antevens/fan-shroud/print/coupons/coupon_pocket.3mf

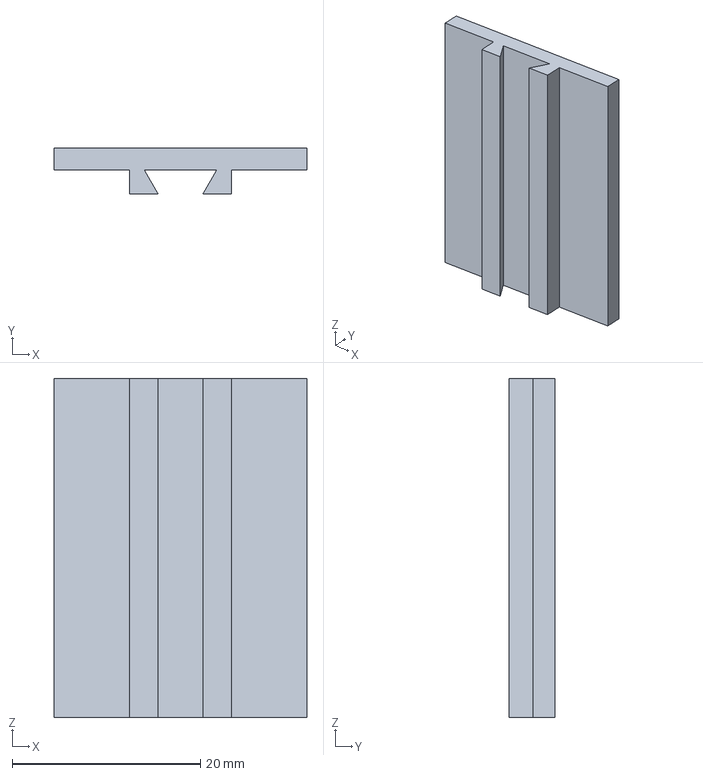
[picture p1: CAD file, 2026-10-30]
print/coupons/coupon_pocket.3mf
26.9 x 4.83 x 36.0 mm
