antevens/fan-shroud/print/grip_slot3.3mf

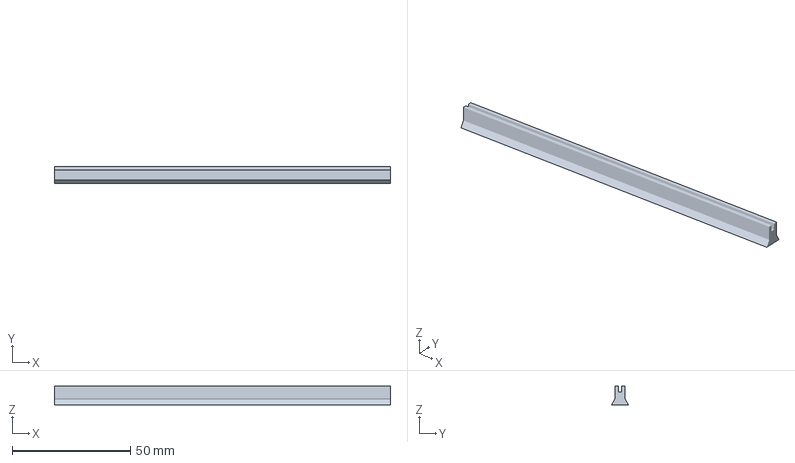
[picture p2: CAD file, 2026-10-30]
print/grip_slot3.3mf
142.0 x 7.26 x 8.00 mm
