antevens/fan-shroud/print/coupons/coupon_grip.3mf

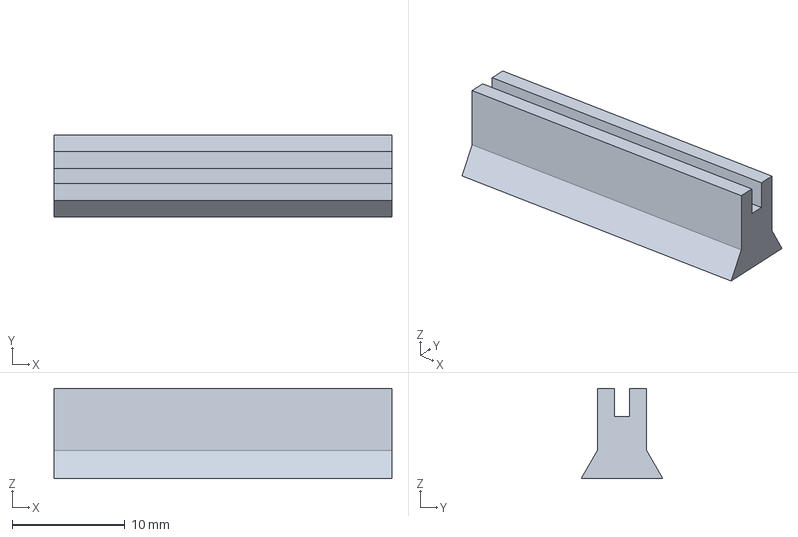
[picture p3: CAD file, 2026-10-30]
print/coupons/coupon_grip.3mf
30.0 x 7.26 x 8.00 mm
