antevens/fan-shroud/print/grip_slot2.3mf

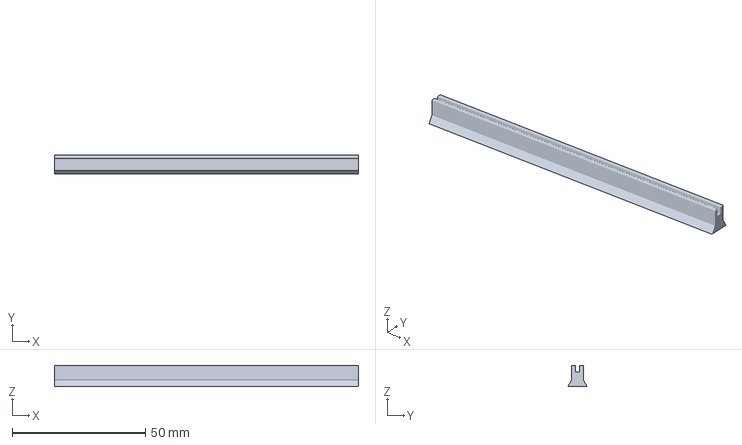
[picture p4: CAD file, 2026-10-30]
print/grip_slot2.3mf
114.2 x 7.26 x 8.00 mm
