antevens/fan-shroud/print/coupons/coupon_fan_mount.3mf

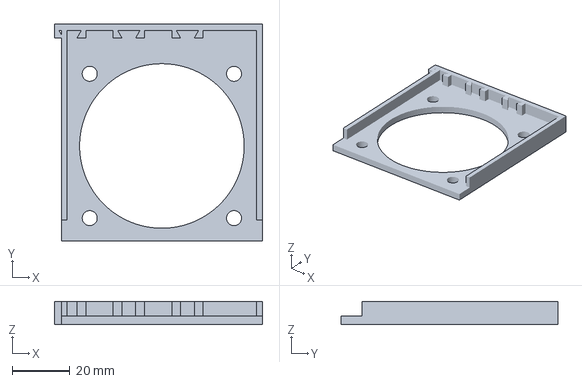
[picture p5: CAD file, 2026-10-30]
print/coupons/coupon_fan_mount.3mf
72.1 x 75.2 x 8.00 mm
