antevens/fan-shroud/print/shroud.3mf

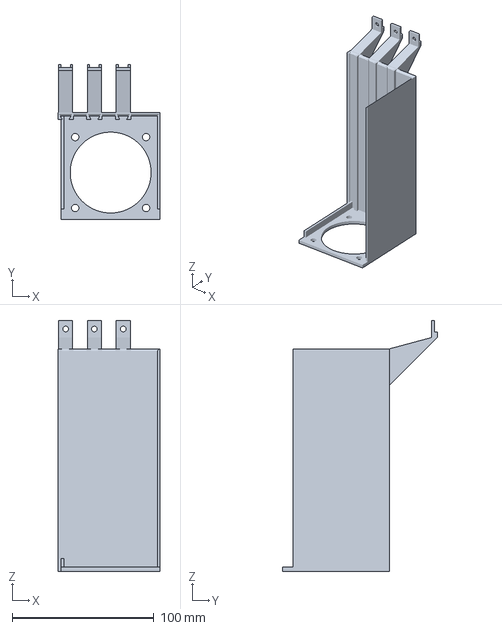
[picture p6: CAD file, 2026-10-30]
print/shroud.3mf
72.1 x 109.0 x 177.0 mm
