antevens/fan-shroud/print/grip_slot1.3mf

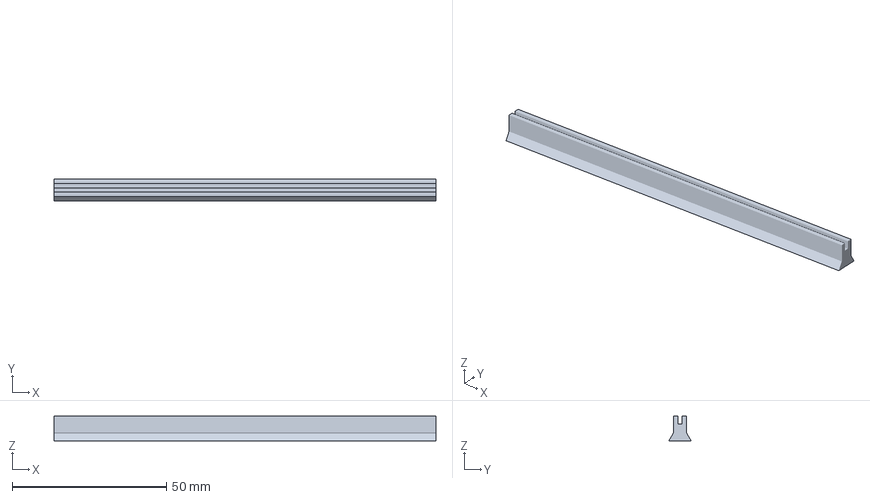
[picture p7: CAD file, 2026-10-30]
print/grip_slot1.3mf
124.0 x 7.26 x 8.00 mm
