antevens/fan-shroud/(commit log)

2026-10-13 Parametric PCIe NIC fan duct, version 0.1
    - build123d model: slim 80 mm fan converging into one channel per usable
    slot, splitter vanes, outlet gasket frame, blanking plugs
    - card_clip mount (default): pocketed side wall and bottom plate riding
    on screwed two-material TPU edge grips, card-independent shroud
    - case mount kept selectable: pegged floor tray and cover
    - headless ElegooSlicer slicing with flattened Centauri Carbon 2 profiles
    - geometry tests for both mount styles plus measurement-range variants
    - README, MEASURE.md caliper checklist, generated PRINTING.md
2026-10-13 Card-clip duct: six-screw joint, 72D/95A TPU roles, slicer-written print set
    Duct-to-shroud joint: screw bars on the bottom and side-panel edges of
    both flanges take six standard fan screws with the gasket clamped
    between; the top lap and flange gussets are gone and the shroud prints
    standing on its tail flange so nothing cantilevers.
    Fan: 25 mm Noctua on a 6 mm flange with M3 heat-set inserts in filled
    corner pads and gussets trimmed to the duct envelope.
    Grips: two-material TPU edge grips with the stiff TPU 72D back holding
    the M2.5 screws and TPU 95A lips; three screw positions per grip; the
    gasket is TPU 95A. The shroud volume no longer depends on card heights.
    Print set: every 3MF in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
    [coupon_fan_flange.3mf, coupon_grip.3mf, coupon_outlet_corner.3mf, coupon_pocket.3mf, duct.3mf, gasket.3mf, grip_slot1.3mf, grip_slot2.3mf]
2026-10-18 One-piece shroud with a 60 mm tail fan and bracket-screw ribs
    The 2026-10-18 test fit measured 78 mm between the GPU and the midplate
    and the PSU cables right at the 170 mm card tails, so the 80 mm fan,
    the separate converging duct and the duct-to-shroud joint do not fit.
    Card-clip build is now one ABS shroud plus the TPU grips:
    - tail end wall 4 mm past the longest card with a round opening and
    four clearance holes for a 60 mm fan (50 mm spacing), fan screws
    driven from inside through the open motherboard side
    - bottom plate 24 mm below the bottom card's PCB for its heatsink
    - one rib per card along the wall's outer face to its bracket-end edge,
    then angled up to an ear under that ca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
    [coupon_fan_flange.3mf, coupon_fan_mount.3mf, coupon_grip.3mf, coupon_outlet_corner.3mf, coupon_pocket.3mf, duct.3mf, gasket.3mf, grip_slot1.3mf]
2026-10-30 Update to dovetail card slots
    [coupon_fan_mount.3mf, coupon_grip.3mf, coupon_pocket.3mf, grip_slot1.3mf, grip_slot2.3mf, grip_slot3.3mf, shroud.3mf]
